OBU5/Heart_rate_monitor_device/Screenshots/IMG_20210420_102033.jpg

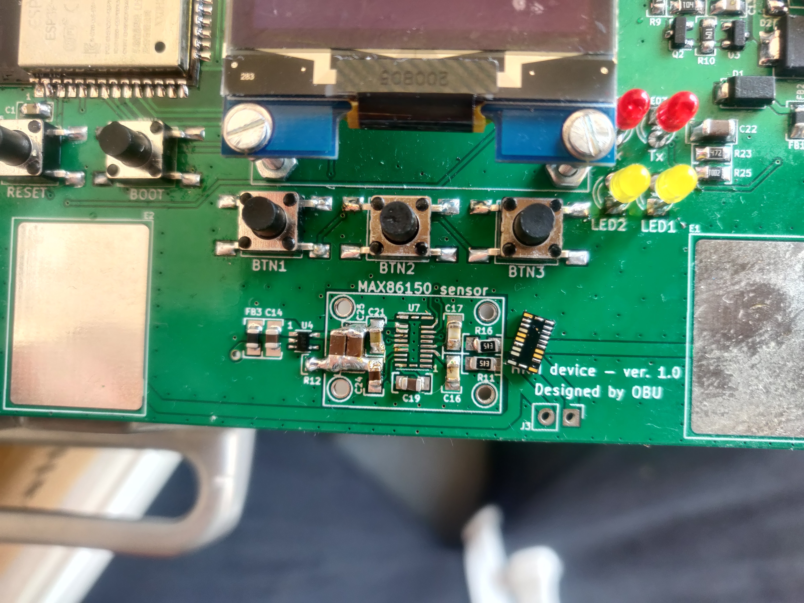
Screenshots/IMG_20210420_102033.jpg
