OBU5/Heart_rate_monitor_device/Screenshots/Horkovzdušná pistole.jpg

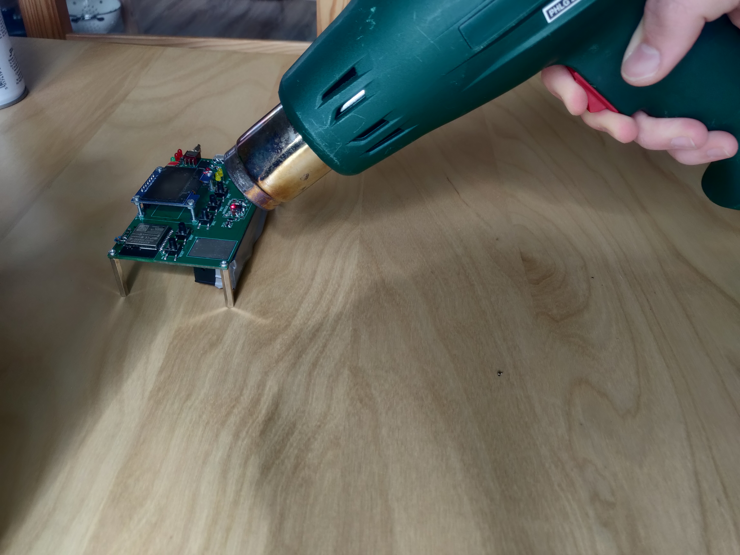
Screenshots/Horkovzdušná pistole.jpg
