OBU5/Heart_rate_monitor_device/Screenshots/I2C-datasheet.png

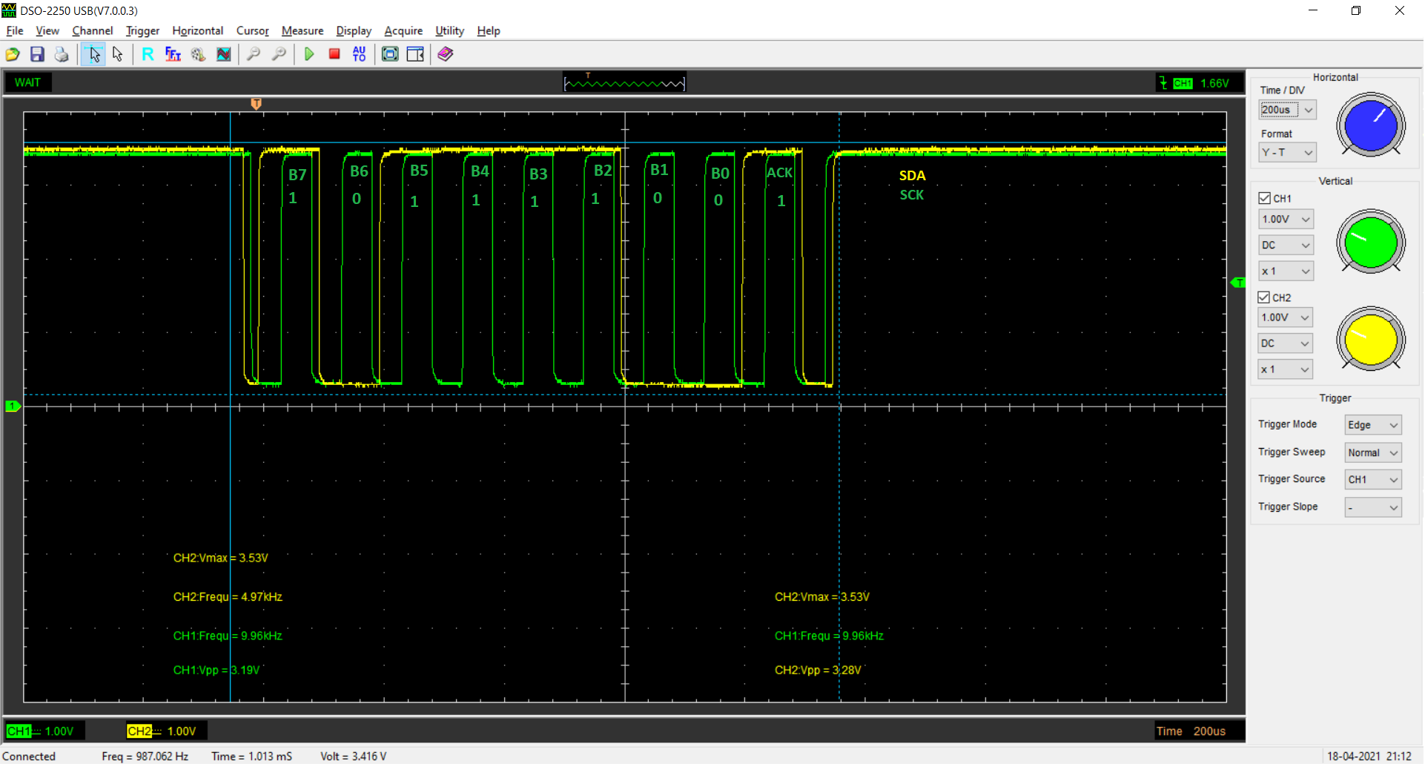
Screenshots/I2C-datasheet.png
