OBU5/Heart_rate_monitor_device/Screenshots/I2C_ppg.png

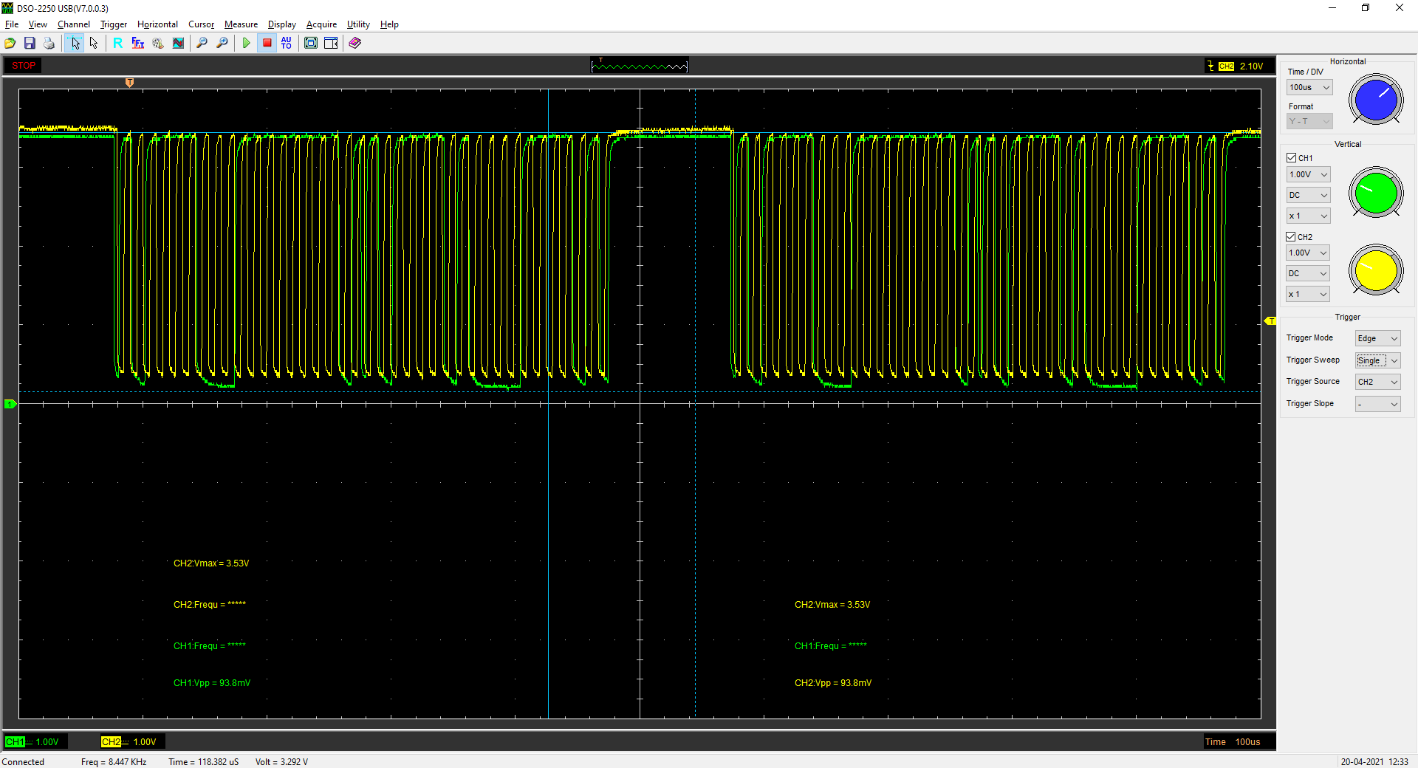
Screenshots/I2C_ppg.png
