OBU5/Heart_rate_monitor_device/Screenshots/ppg.png

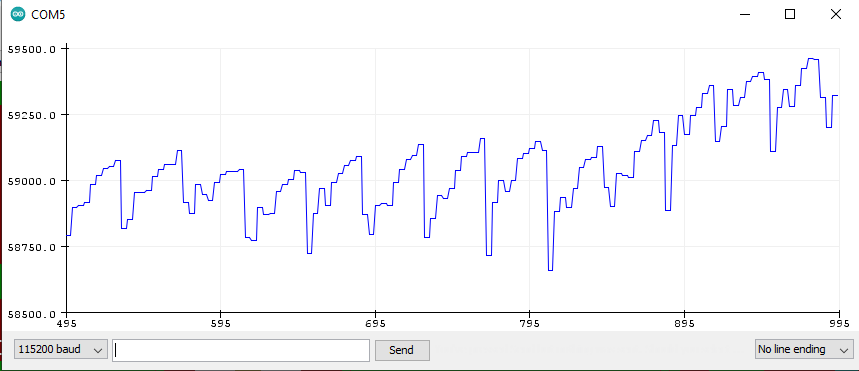
Screenshots/ppg.png
