OBU5/Heart_rate_monitor_device/Screenshots/ppg_fast.png

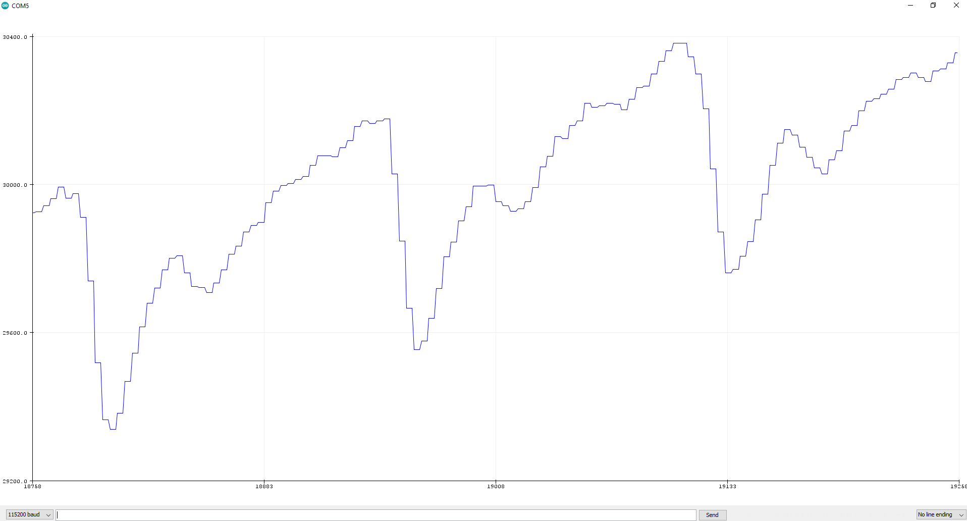
Screenshots/ppg_fast.png
