OBU5/Heart_rate_monitor_device/Screenshots/ppg_visualizedData.png

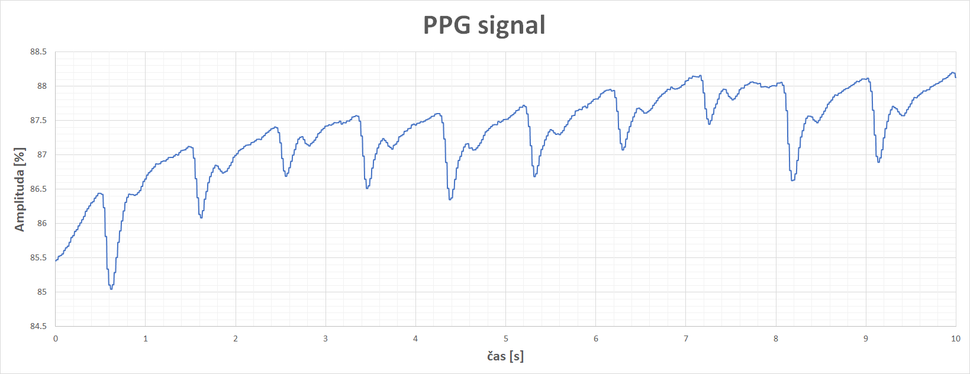
Screenshots/ppg_visualizedData.png
