OBU5/Heart_rate_monitor_device/Screenshots/Senzor po pájení horkovzdušnou pistolí.jpg

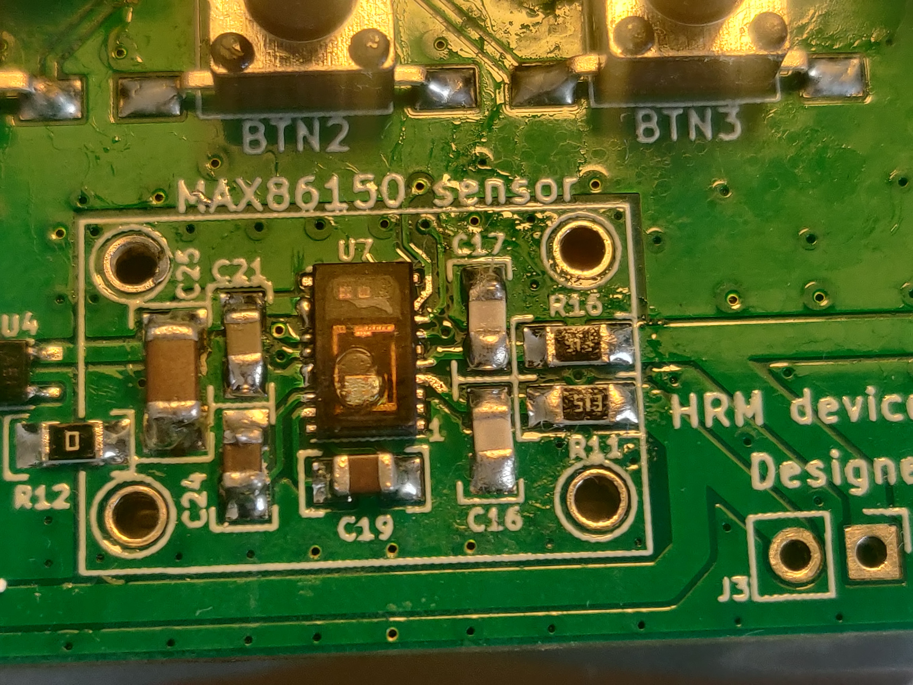
Screenshots/Senzor po pájení horkovzdušnou pistolí.jpg
