OBU5/Heart_rate_monitor_device/Screenshots/senzor_PCB.png

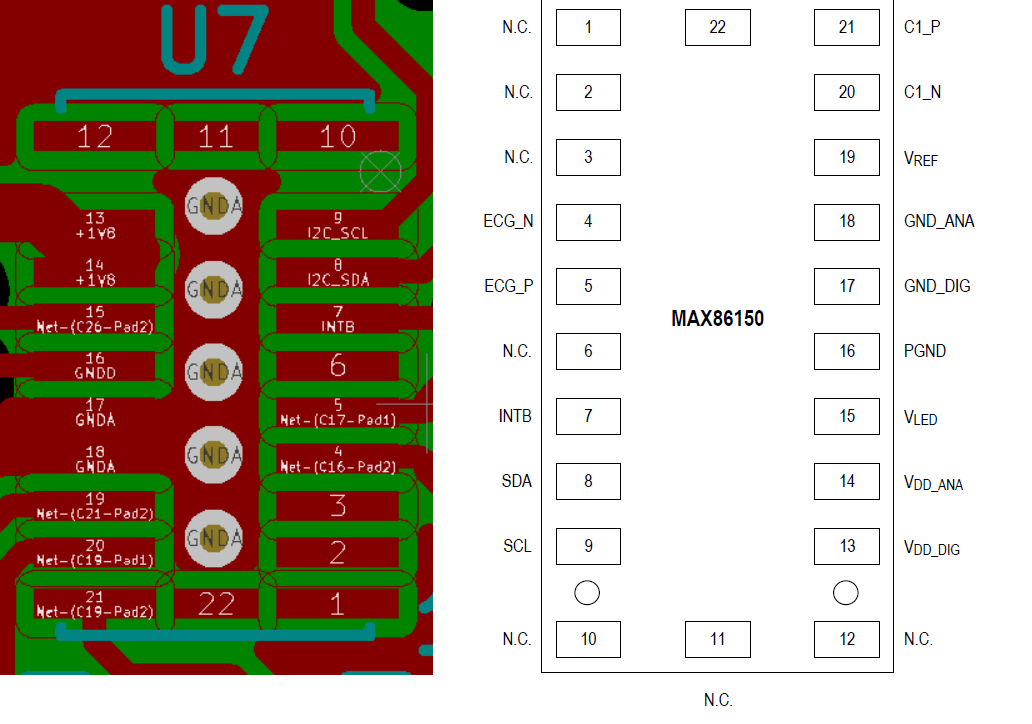
Screenshots/senzor_PCB.png
