OBU5/Heart_rate_monitor_device/Screenshots/zapojeni_senzoru.png

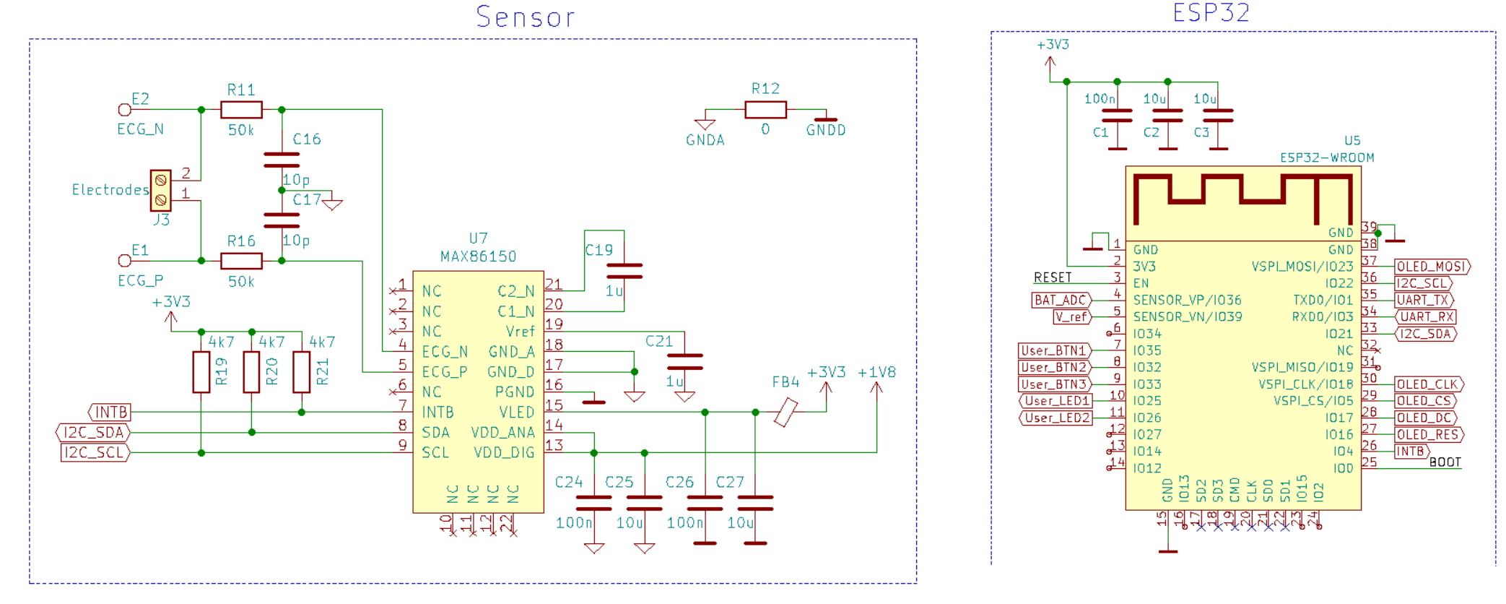
Screenshots/zapojeni_senzoru.png
