OBU5/Heart_rate_monitor_device/HW/ver. 1/HRM/Schematic - ver.1.pdf

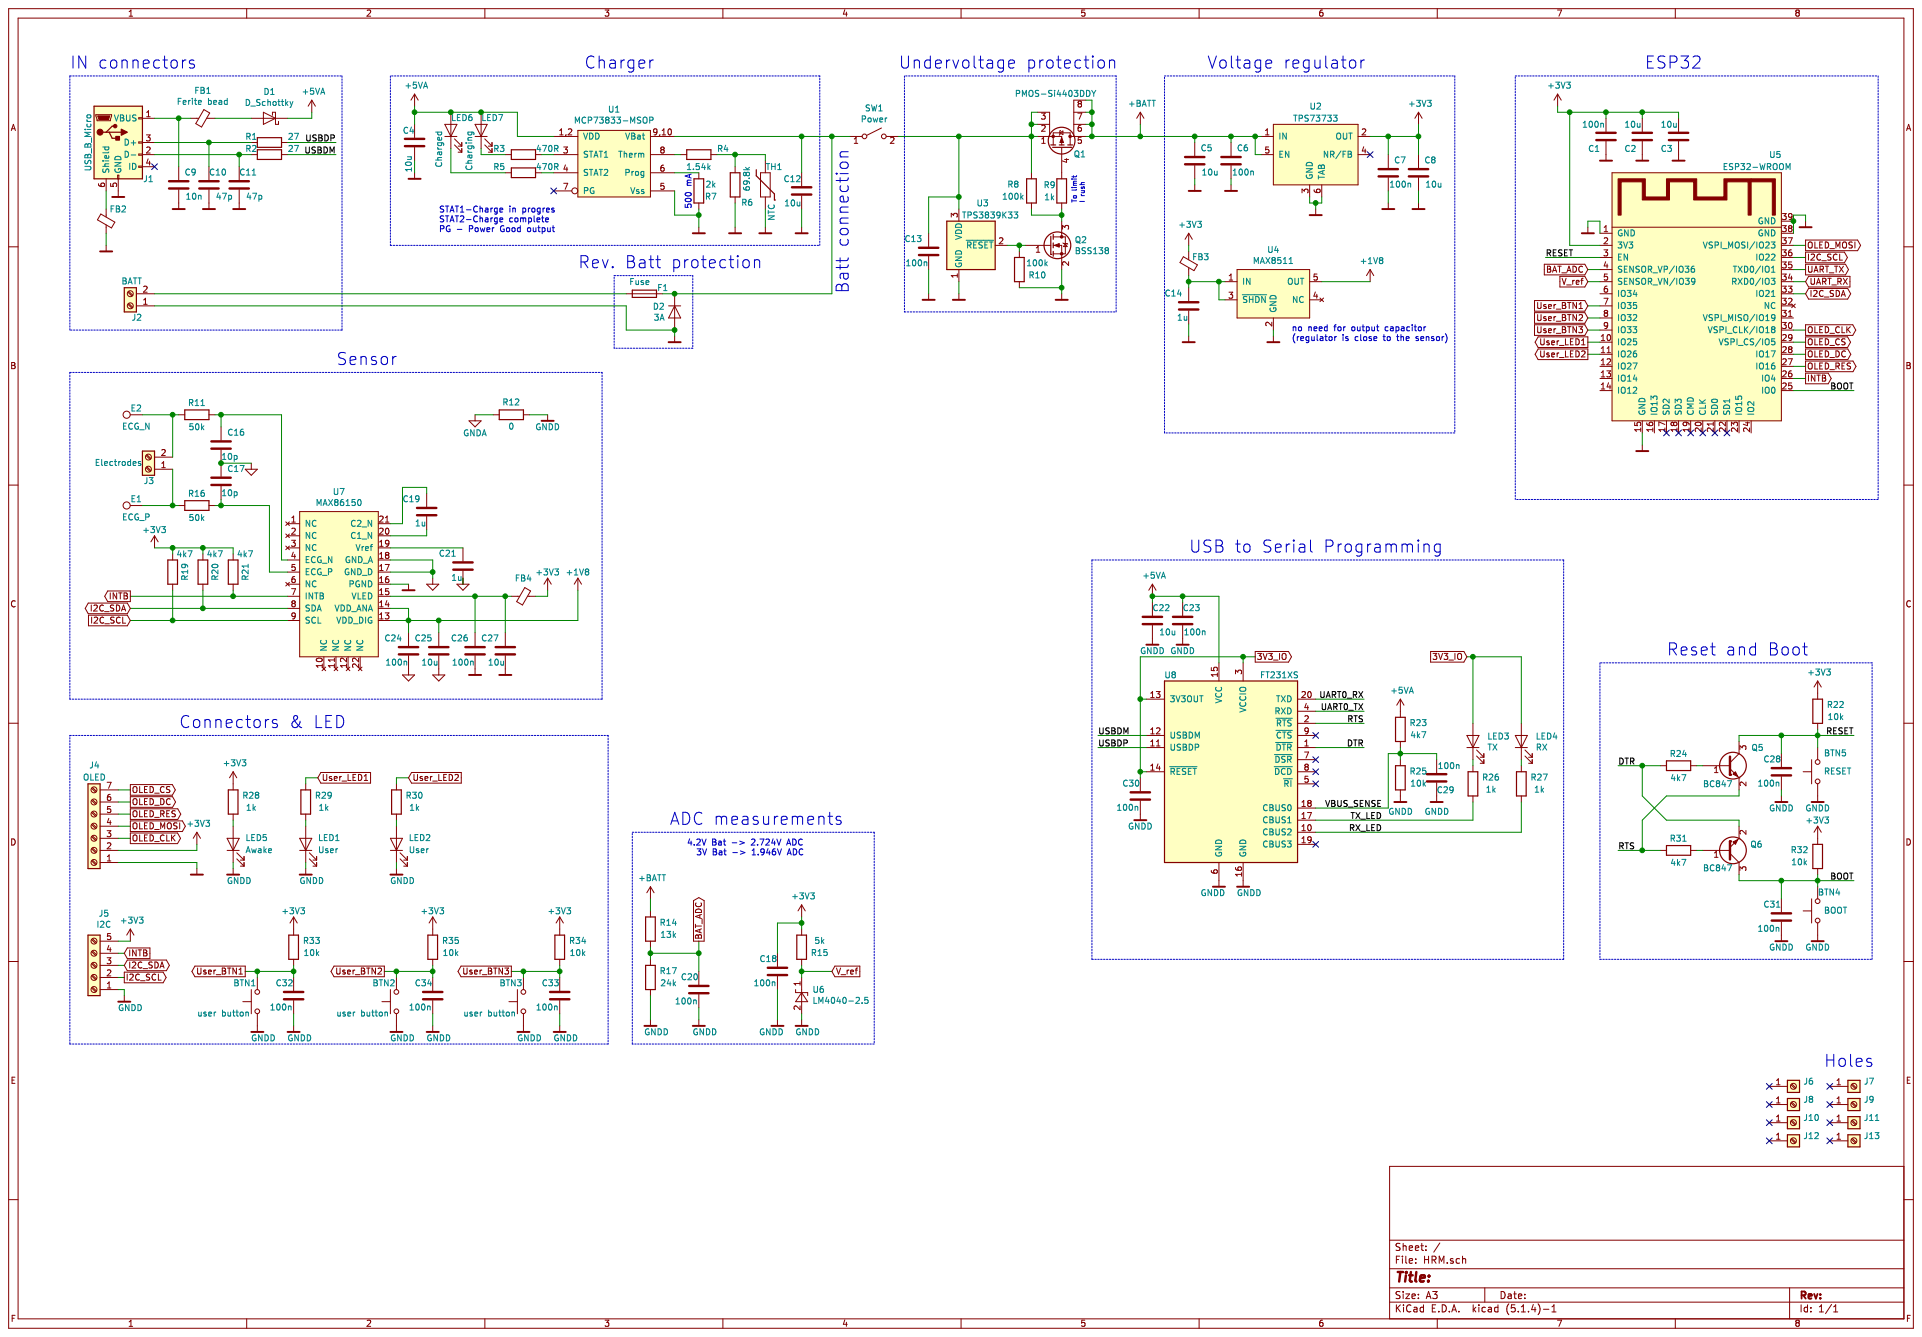
[picture p12: page 1]
