OBU5/Heart_rate_monitor_device/HW/ver. 1/HRM/HRM.kicad_pcb

## KiCad design HW/ver. 1/HRM/HRM.kicad_pcb (2021-04-19)

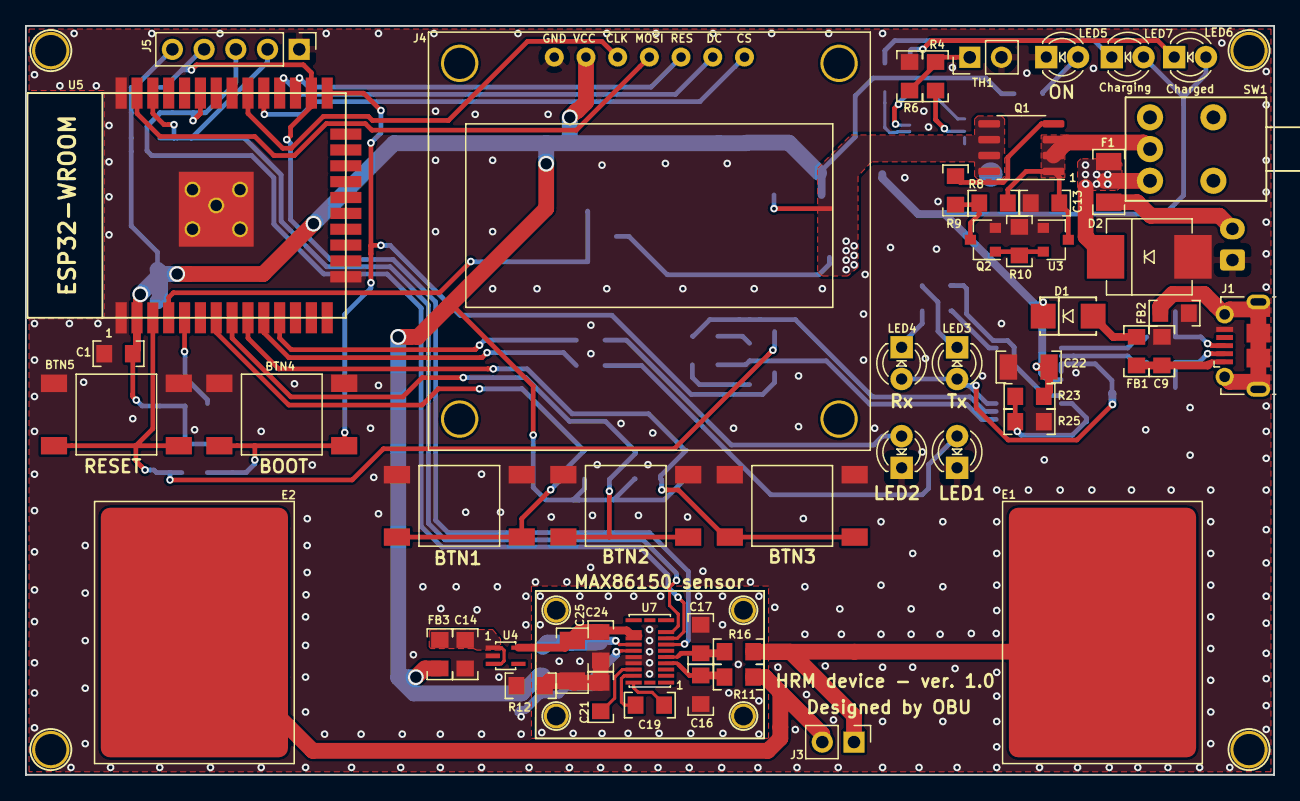
[picture p13: board HRM.kicad_pcb from above]

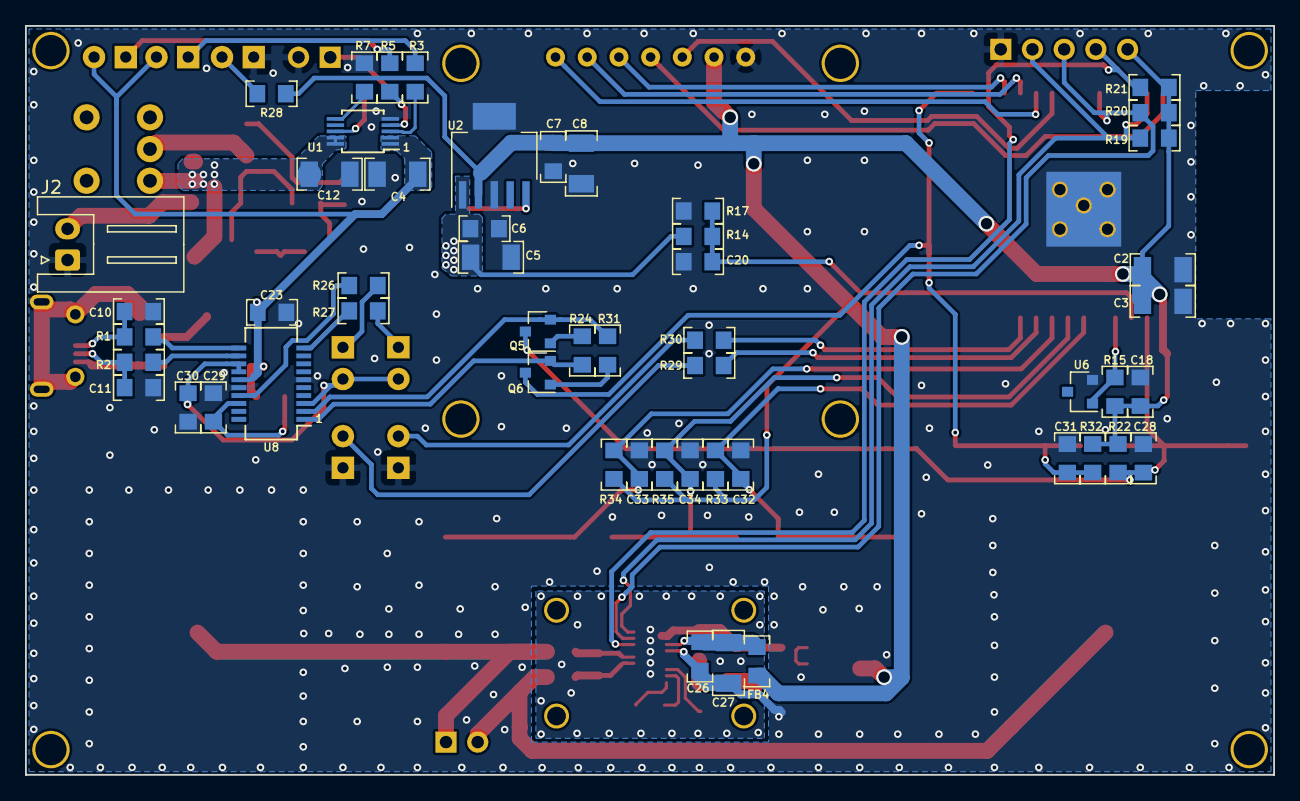
[picture p14: board HRM.kicad_pcb from below]

Board: 2 copper layers, 100.0 x 60.0 mm, 114 parts (53 on the bottom side), 65 nets.

Parts:
BTN1, BTN2, BTN3: user button; BTN_6x6mm
BTN4: BOOT; BTN_6x6mm
BTN5: RESET; BTN_6x6mm
C1, C6, C7, C13, C18, C20, C23, C24, C26, C28, C29, C30, C31, C32, C33, C34: 100n; C0805
C2, C3, C4, C5, C8, C12, C22, C25, C27: 10u; C1206
C9: 10n; C0805
C10, C11: 47p; C0805
C14, C19, C21: 1u; C0805
C16, C17: 10p; C0805
D1: D_Schottky; D_SMA
D2: 3A; D_SMC
E1: ECG_P; Electrode
E2: ECG_N; Electrode
F1: Fuse; R1206
FB1, FB2, FB3, FB4: Ferite bead; R0805
J1: USB_B_Micro; USB_Micro-B_Molex-105017-0001
J2: BATT; JST_XH_S2B-XH-A_1x02_P2.50mm_Horizontal
J3: Electrodes; PinHeader_1x02_P2.54mm_Vertical
J4: OLED; 1.3_inch_OLED
J5: I2C; PinHeader_1x05_P2.54mm_Vertical
J6, J8, J10, J12: Screw_Terminal_01x01; Screwh_hole-1.5mm
J7, J9, J11, J13: Screw_Terminal_01x01; Screwh_hole-2.5mm
LED1, LED2: User; LED-THT-3.0mm
LED3: TX; LED-THT-3.0mm
LED4: RX; LED-THT-3.0mm
LED5: Awake; LED-THT-3.0mm
LED6: Charged; LED-THT-3.0mm
LED7: Charging; LED-THT-3.0mm
Q1: PMOS-Si4403DDY; SO-8_3.9x4.9mm_P1.27mm
Q2: BSS138; SOT-23
Q5, Q6: BC847; SOT-23
R1, R2: 27; R0805
R3, R5: 470R; R0805
R4: 1.54k; R0805
R6: 69.8k; R0805
R7, R9, R26, R27, R28, R29, R30: 1k; R0805
R8, R10: 100k; R0805
R11, R16: 50k; R0805
R12: 0; R0805
R14: 13k; R0805
R15: 5k; R0805
R17: 24k; R0805
R19, R20, R21, R23, R24, R31: 4k7; R0805
R22, R25, R32, R33, R34, R35: 10k; R0805
SW1: Power; Switch_P-KNX125
TH1: NTC; PinHeader_1x02_P2.54mm_Vertical
U1: MCP73833-MSOP; MSOP-10_3x3mm_P0.5mm
U2: TPS73733; SOT-223-6
U3: TPS3839K33; SOT-23
U4: MAX8511; SC70-5pin
U5: ESP32-WROOM
U6: LM4040-2.5; SOT-23
U7: MAX86150; OLGA-22pin
U8: FT231XS; SSOP-20_3.9x8.7mm_P0.635mm

Connections:
3V3_IO: C30.2, LED3.2, LED4.2, U8.3, U8.13, U8.14
+1V8: C24.2, C25.2, U4.5, U7.13, U7.14
+3V3: C1.1, C2.1, C3.1, C7.2, C8.2, C18.2, FB3.2, FB4.1, J4.2, J5.5, R15.2, R19.1, R20.1, R21.1, R22.2, R28.2, R32.2, R33.2, R34.2, R35.2, U2.2, U5.2
+5VA: C4.1, C22.2, C23.2, D1.1, LED6.2, LED7.2, R23.2, U1.1, U1.2, U8.15
+BATT: C5.2, C6.2, Q1.5, Q1.6, Q1.7, Q1.8, R14.2, U2.1, U2.5
/BOOT: BTN4.2, C31.2, Q6.3, R32.1, U5.25
/DTR: Q6.2, R24.2, U8.1
/RESET: BTN5.2, C28.2, Q5.3, R22.1, U5.3
/RTS: Q5.2, R31.2, U8.2
/RX_LED: R27.1, U8.10
/TX_LED: R26.1, U8.17
/USBDM: R2.1, U8.12
/USBDP: R1.1, U8.11
/VBUS_SENSE: C29.1, R23.1, R25.2, U8.18
BAT_ADC: C20.2, R14.1, R17.2, U5.4
GNDA: C16.1, C17.2, C21.1, C24.1, C25.1, R12.1, U7.17, U7.18
GNDD: BTN1.1, BTN2.1, BTN3.1, BTN4.1, BTN5.1, C1.2, C2.2, C3.2, C4.2, C5.1, C6.1, C7.1, C8.1, C9.1, C10.1, C11.1, C12.2, C13.1, C14.1, C18.1, C20.1, C22.1, C23.1, C26.1, C27.1, C28.1, C29.2, C30.1, C31.1, C32.1, C33.1, C34.1, D2.2, FB2.2, J1.5, J2.1, J4.1, J5.1, LED1.1, LED2.1, LED5.1, Q2.2, R6.1, R7.1, R10.1, R12.2, R17.1, R25.1, TH1.2, U1.5, U2.3, U2.6, U3.1, U4.2, U5.1, U5.15, U5.38, U5.39, U6.2, U7.16, U8.6, U8.16
I2C_SCL: J5.2, R19.2, U5.36, U7.9
I2C_SDA: J5.3, R20.2, U5.33, U7.8
INTB: J5.4, R21.2, U5.26, U7.7
unnamed: C9.2, FB1.1, J1.1
unnamed: C10.2, J1.3, R1.2
unnamed: C11.2, J1.2, R2.2
unnamed: C12.1, D2.1, F1.2, SW1.1, U1.9, U1.10
unnamed: C13.2, Q1.1, Q1.2, Q1.3, R8.2, SW1.2, U3.3
unnamed: C14.2, FB3.1, U4.1, U4.3
unnamed: C16.2, R11.1, U7.4
unnamed: C17.1, R16.1, U7.5
unnamed: C19.1, U7.20
unnamed: C19.2, U7.21
unnamed: C21.2, U7.19
unnamed: C26.2, C27.2, FB4.2, U7.15
unnamed: D1.2, FB1.2
unnamed: E1.1, J3.1, R16.2
unnamed: E2.1, J3.2, R11.2
unnamed: F1.1, J2.2
unnamed: FB2.1, J1.6
unnamed: LED1.2, R29.1
unnamed: LED2.2, R30.1
unnamed: LED3.1, R26.2
unnamed: LED4.1, R27.2
unnamed: LED5.2, R28.1
unnamed: LED6.1, R5.2
unnamed: LED7.1, R3.2
unnamed: Q1.4, R9.1
unnamed: Q2.1, R10.2, U3.2
unnamed: Q2.3, R8.1, R9.2
unnamed: Q5.1, R24.1
unnamed: Q6.1, R31.1
unnamed: R3.1, U1.3
unnamed: R4.1, R6.2, TH1.1
unnamed: R4.2, U1.8
unnamed: R5.1, U1.4
unnamed: R7.2, U1.6
OLED_CLK: J4.3, U5.30
OLED_CS: J4.7, U5.29
OLED_DC: J4.6, U5.28
OLED_MOSI: J4.4, U5.37
OLED_RES: J4.5, U5.27
User_BTN1: BTN1.2, C32.2, R33.1, U5.7
User_BTN2: BTN2.2, C34.2, R35.1, U5.8
User_BTN3: BTN3.2, C33.2, R34.1, U5.9
User_LED1: R29.2, U5.10
User_LED2: R30.2, U5.11
V_ref: R15.1, U5.5, U6.1
