OBU5/Heart_rate_monitor_device/(commit log)

2021-02-26 Added more parts of schema design
    [BOM.xlsx, HRM.kicad_pcb, HRM.sch, HRM.xlsx]
2021-02-27 Added labels on MCU pins
    [HRM.sch]
2021-03-09 finished schema
    [HRM.kicad_pcb, HRM.sch]
2021-03-12 one of last schematic updates
    [HRM.kicad_pcb, HRM.sch]
2021-04-15 Design of PCB
    [HRM-B_Cu.gbr, HRM-B_Mask.gbr, HRM-B_SilkS.gbr, HRM-Edge_Cuts.gbr, HRM-F_Cu.gbr, HRM-F_Mask.gbr, HRM-F_SilkS.gbr, HRM-NPTH.drl]
2021-04-19 added script that prints sine wave on 1.3" OLED display
    [HRM.kicad_pcb]
2021-04-20 Finally finished HW. Also added demo software and pictures of the device
    HW part is done. There was a problem with sensor soldering, but heat gun fixed it. Also demo software was implemented - only sends measured data in realtime. Also some photos of the PCB and measured data were added
    [Measured data.xlsx]
