OBU5/Heart_rate_monitor_device/Screenshots/Senzor po odpajení horkovzduškou.jpg

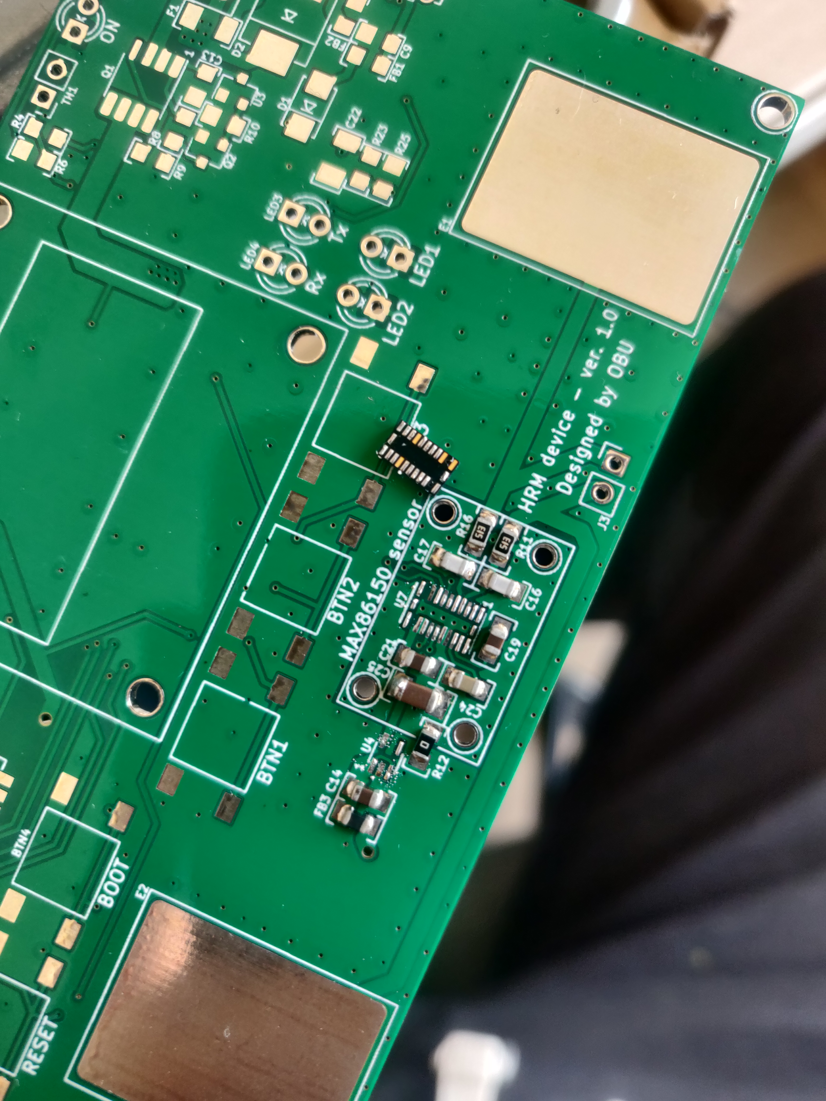
Screenshots/Senzor po odpajení horkovzduškou.jpg
